diaz-eddieEE/wind-power-station/(commit log)

2026-11-03 Create README for Wind Power Station project
    Added detailed documentation for the Wind Power Station project, including key results, hardware used, wiring, code, methods, experiments, and future steps.
2026-11-03 Create README for wind power station project
    Added detailed README for wind power station project, including key results, hardware used, wiring, code, methodology, experiments, and next steps.
2026-11-03 Initial commit of Wind Power Station README
    Added detailed documentation for the Wind Power Station project, including key results, hardware used, wiring details, code explanation, experimental methods, findings, and next steps.
